shreejita56/MicroPAD-PROPLUS/README.md

# MicroPAD-PROPLUS


So I made a custom 3x3 Micropad based on Xiao RP2040 and it has  a rotor encoder on top . We have used diodes to prevent ghosting , the Switches are hot-swappable and it has a compact design.
<br>
The PCB Design was made on Kicad. Here I used the SMD Footprint for the Xiao Rp2040 and Hot-Swappable Footprint for the Switches . The rotor encoder at the top of the matrix also works as a switch . So In total We can use this MicroPad for 9 different Shortcuts and the rotor encoder can be used as a Volume Controller.Also It has per switch LEDS as well <br>

We have also used a Diode with each Switch , So that we can prevent Ghosting. The PCB also have few connection holes which helps it to connect with the CASE Properly.
<br>
I have tried to make the PCB design as compact as I could <br>

Then Comes the CAD . Which was Done in fusion . I Tracked the boundary of the PCB with come relief space then marked the Connection hole on the PCB as well . After which I designed the Bottom Case onto which the PCB Rests and Then I made a 3X3 Center case to hold the Switches and a Top case to add the finish and at the end I made hole for the USB-C connection and made the Base case in a angle so that It sits on a angle on the table.
<br>

Lastly I made the Firmware for the PCB which I wrote completely in C language .

### Features
- 3x3 Switch Design with rotor encoder on top
- Per switch LED and Diode for ghosting
- Compact Design
- Three layered Case with base (Structured at an angle )

  ## Usage Instructions

  So 'first I Soldered the Hot-Swapes onto the board and after that I soldered the diodes onto the other side ,prior to that I Soldered the LEDS and then at the END I soldered the Rotor Encoder and the Xiao Rp2040. After that I assembled the PCB onto the base and then I added the Switch assembles with the Middle layer onto the PCB and at the End I added the top layer CAD and added the KeyCaps. 

- # Bill of Materials (BOM)

| Item | Price (USD) | Source |
|---|---:|---|
| PCB + Shipping (after coupons) | 0 Already have| JLCPCB |
| Xiao RP2040 + Shipping | 0 Already have | https://robocraze.com/products/seeed-studio-xiao-rp2040-development-board |
| Keycaps (Pack of 5) ×2 | 0 Already have | https://meckeys.com/shop/accessories/keyboard-accessories/keycaps/blank/blank-dsa-keycaps-1u/ |
| Switches (Pack of 10) | 0 Already have| https://neomacro.in/products/hmx-snowfall-tactile-switch |
| Hot-Swap Sockets (Pack of 10) | 0 Already have| https://meckeys.com/shop/accessories/keyboard-accessories/key-switches/kailh-hot-swap-socket/ |
| Meckeys Shipping | 0 Already have | https://meckeys.com |
| Diodes (10 pcs) | Already have | — |
| Rotary Encoder | Already have | — |
| **Total** | **0.00** | |

## Schematics 


## PCB 




## 3D Design 



## Built View 



## Demo Link
youtube.com/shorts/5VS75XL_3SE?feature=share
