shreejita56/MicroPAD-PROPLUS/BOM.csv

Item | Price | Source
PCB + Shipping - Coupons | 0 Already have) | JLCPCB
Xiao Rp2040 + Shipping | 0 Already have | https://robocraze.com/products/seeed-studio-xiao-rp2040-development-board?variant=47742255562976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
Key Caps(pack of 5)x2 | 0 Already have | https://meckeys.com/shop/accessories/keyboard-accessories/keycaps/blank/blank-dsa-keycaps-1u/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
Switches(pack of 10) | 0 Already have | https://neomacro.in/products/hmx-snowfall-tactile-switch?variant=50878813503766
HotSwap(pack of 10) | 0 Already have | https://meckeys.com/shop/accessories/keyboard-accessories/key-switches/kailh-hot-swap-socket/
meckeys shipping | 0 Already have | meckeys.com
Diodes ( 10 pieces) | already have
rotor encoder | already have
Total | 0
