shreejita56/MicroPAD-PROPLUS/CAD/MacroPad ProPlus.step

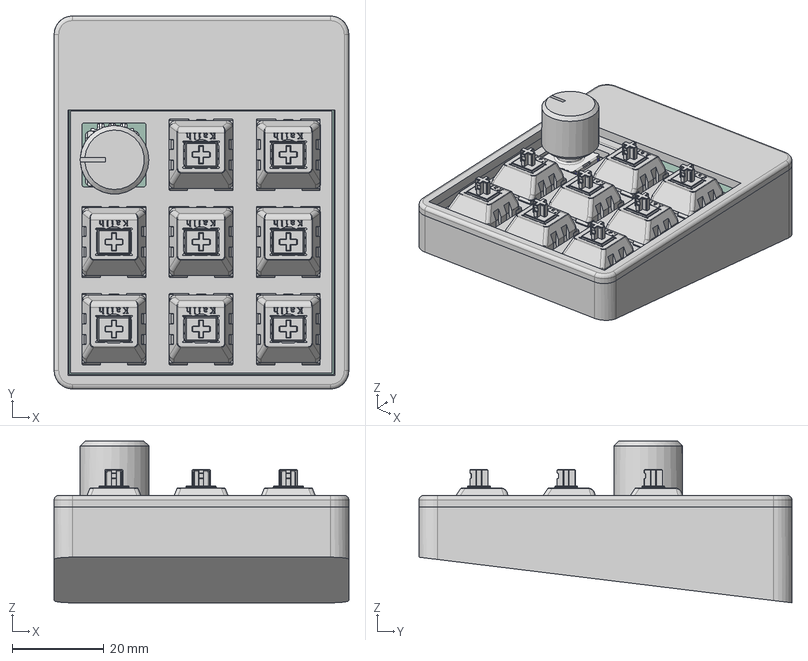
[picture p1: CAD file, 2026-10-09]
CAD/MacroPad ProPlus.step
64.4 x 81.5 x 35.3 mm
