shreejita56/MicroPAD-PROPLUS/Production/CAD/Base.stl

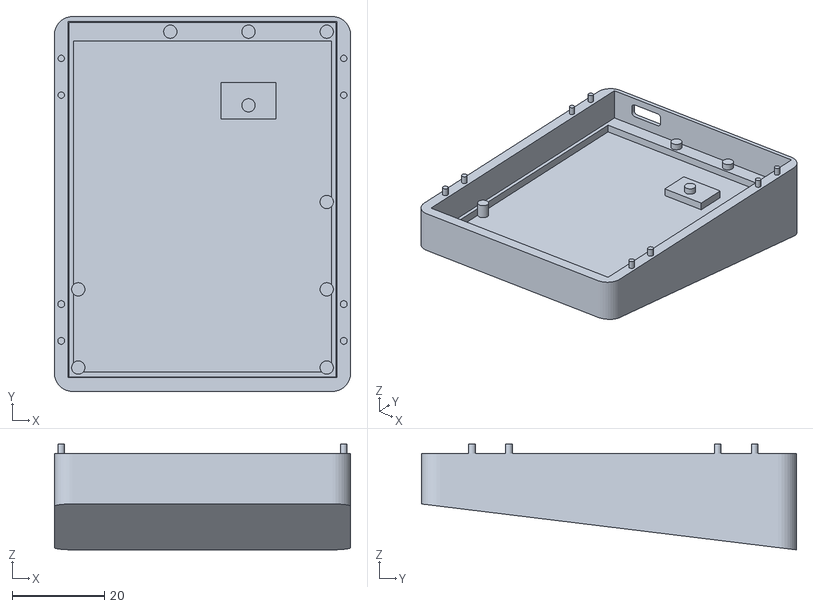
[picture p2: CAD file, 2026-10-09]
Production/CAD/Base.stl
64.4 x 81.5 x 23.0
