shreejita56/MicroPAD-PROPLUS/Production/CAD/Middle.stl

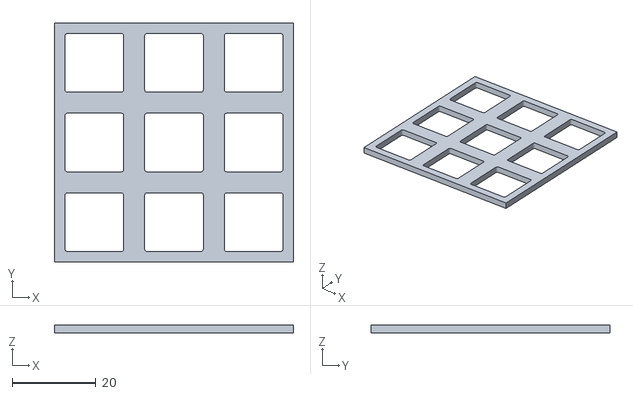
[picture p3: CAD file, 2026-10-09]
Production/CAD/Middle.stl
57.1 x 57.1 x 2.00
