shreejita56/MicroPAD-PROPLUS/Production/CAD/TOP.stl

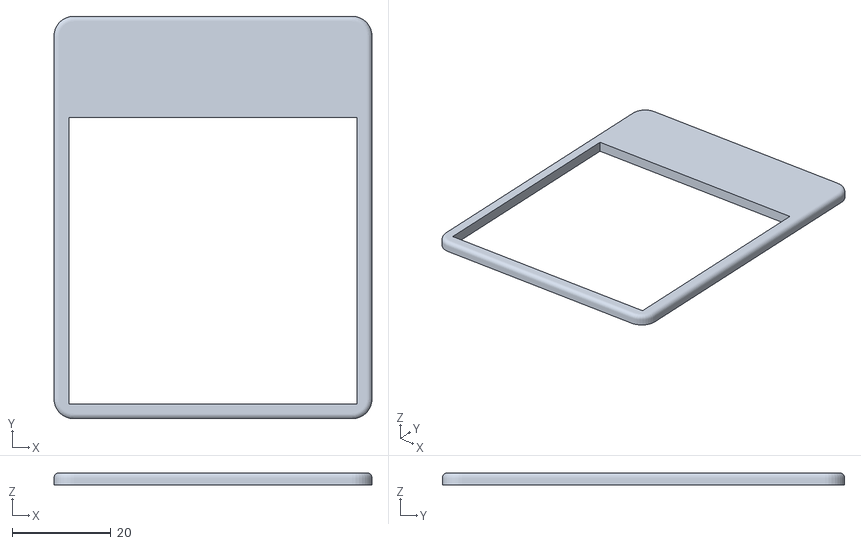
[picture p4: CAD file, 2026-10-09]
Production/CAD/TOP.stl
64.4 x 81.5 x 2.50
