shreejita56/MicroPAD-PROPLUS/(list of files, cad)

Other CAD files:
CAD/MacroPad ProPlus.f3d
