shreejita56/MicroPAD-PROPLUS/PCB/MicroPad ProPlus.kicad_pcb

## KiCad design PCB/MicroPad ProPlus.kicad_pcb (2026-10-09)

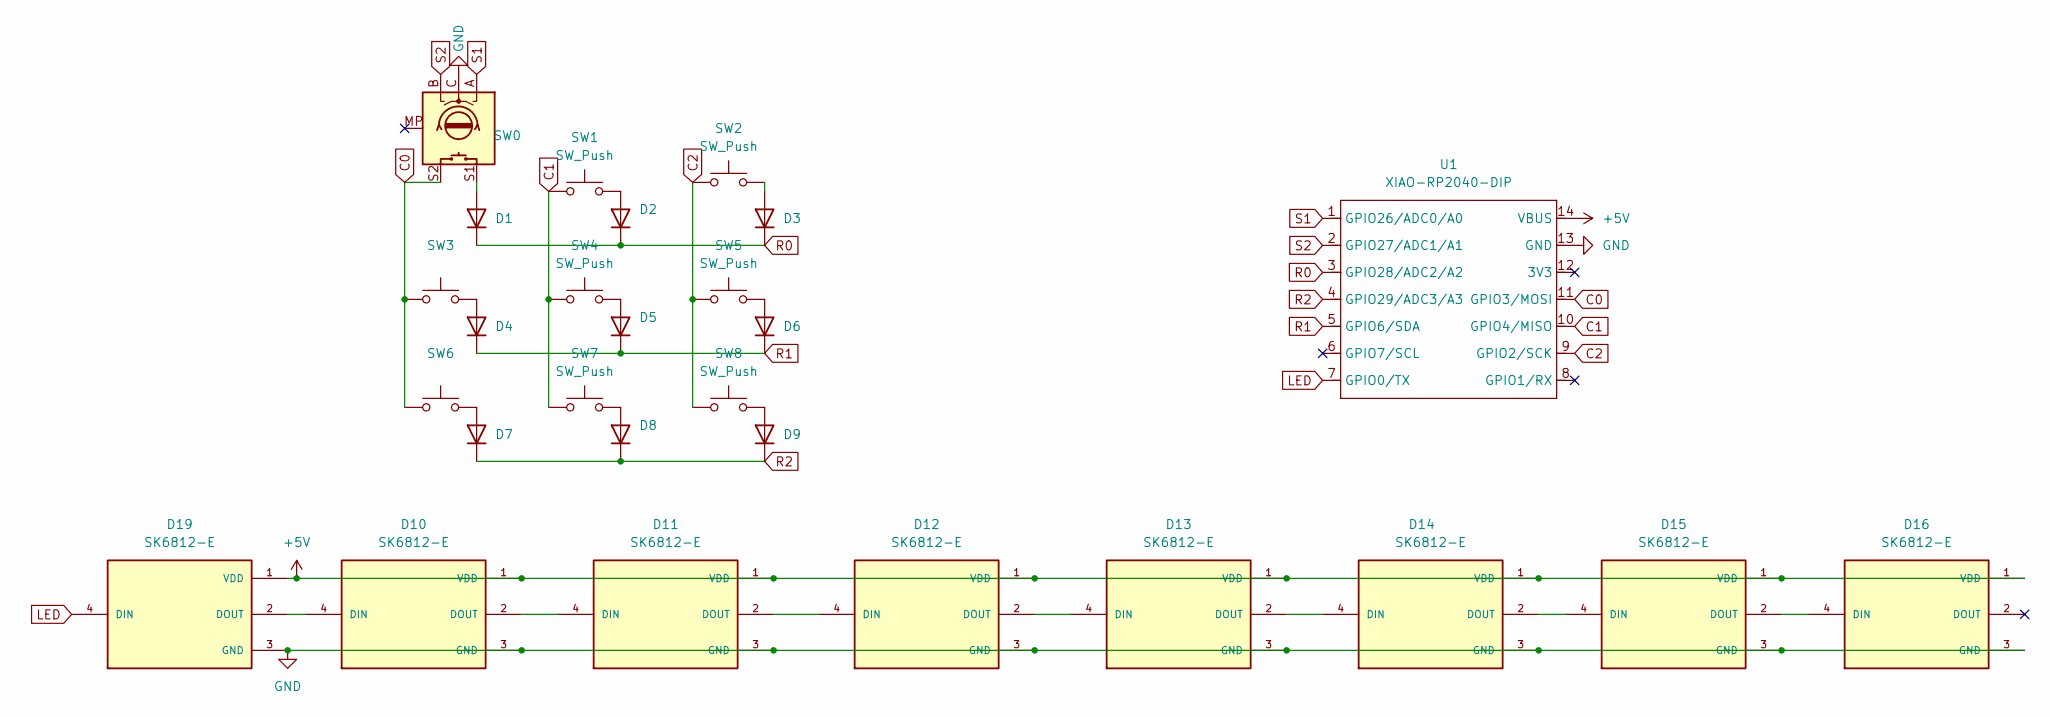
[picture p5: schematic MicroPad ProPlus.kicad_sch]

Parts:
D1, D2, D3, D4, D5, D6, D7, D8, D9: 1N4148; D_DO-35_SOD27_P7.62mm_Horizontal
D10, D11, D12, D13, D14, D15, D16, D19: SK6812-E; LED_SK6812-E; PARTREV 2
SW0: RotaryEncoder_Switch_MP; RotaryEncoder_Alps_EC11E-Switch_Vertical_H20mm
SW1, SW2, SW3, SW4, SW5, SW6, SW7, SW8: SW_Push; MX100H
U1: XIAO-RP2040-DIP

Connections:
+5V: D10.1 (VDD), D11.1 (VDD), D12.1 (VDD), D13.1 (VDD), D14.1 (VDD), D15.1 (VDD), D16.1 (VDD), D19.1 (VDD), U1.14 (VBUS); also elsewhere on the board
C0: SW0.S2, SW3.1, SW6.1, U1.11 (GPIO3/MOSI)
C1: SW1.1, SW4.1, SW7.1, U1.10 (GPIO4/MISO)
C2: SW2.1, SW5.1, SW8.1, U1.9 (GPIO2/SCK)
GND: D10.3 (GND), D11.3 (GND), D12.3 (GND), D13.3 (GND), D14.3 (GND), D15.3 (GND), D16.3 (GND), D19.3 (GND), SW0.C, U1.13 (GND); also elsewhere on the board
LED: D10.4 (DIN), D19.2 (DOUT), D19.4 (DIN), U1.7 (GPIO0/TX)
unnamed: D1.2 (A), SW0.S1
unnamed: D2.2 (A), SW1.2
unnamed: D3.2 (A), SW2.2
unnamed: D4.2 (A), SW3.2
unnamed: D5.2 (A), SW4.2
unnamed: D6.2 (A), SW5.2
unnamed: D7.2 (A), SW6.2
unnamed: D8.2 (A), SW7.2
unnamed: D9.2 (A), SW8.2
unnamed: D10.2 (DOUT), D11.4 (DIN)
unnamed: D11.2 (DOUT), D12.4 (DIN)
unnamed: D12.2 (DOUT), D13.4 (DIN)
unnamed: D13.2 (DOUT), D14.4 (DIN)
unnamed: D14.2 (DOUT), D15.4 (DIN)
unnamed: D15.2 (DOUT), D16.4 (DIN)
unnamed 21: D16.2 (DOUT); also elsewhere on the board
R0: D1.1 (K), D2.1 (K), D3.1 (K), U1.3 (GPIO28/ADC2/A2)
R1: D4.1 (K), D5.1 (K), D6.1 (K), U1.5 (GPIO6/SDA)
R2: D7.1 (K), D8.1 (K), D9.1 (K), U1.4 (GPIO29/ADC3/A3)
S1: SW0.A, U1.1 (GPIO26/ADC0/A0)
S2: SW0.B, U1.2 (GPIO27/ADC1/A1)

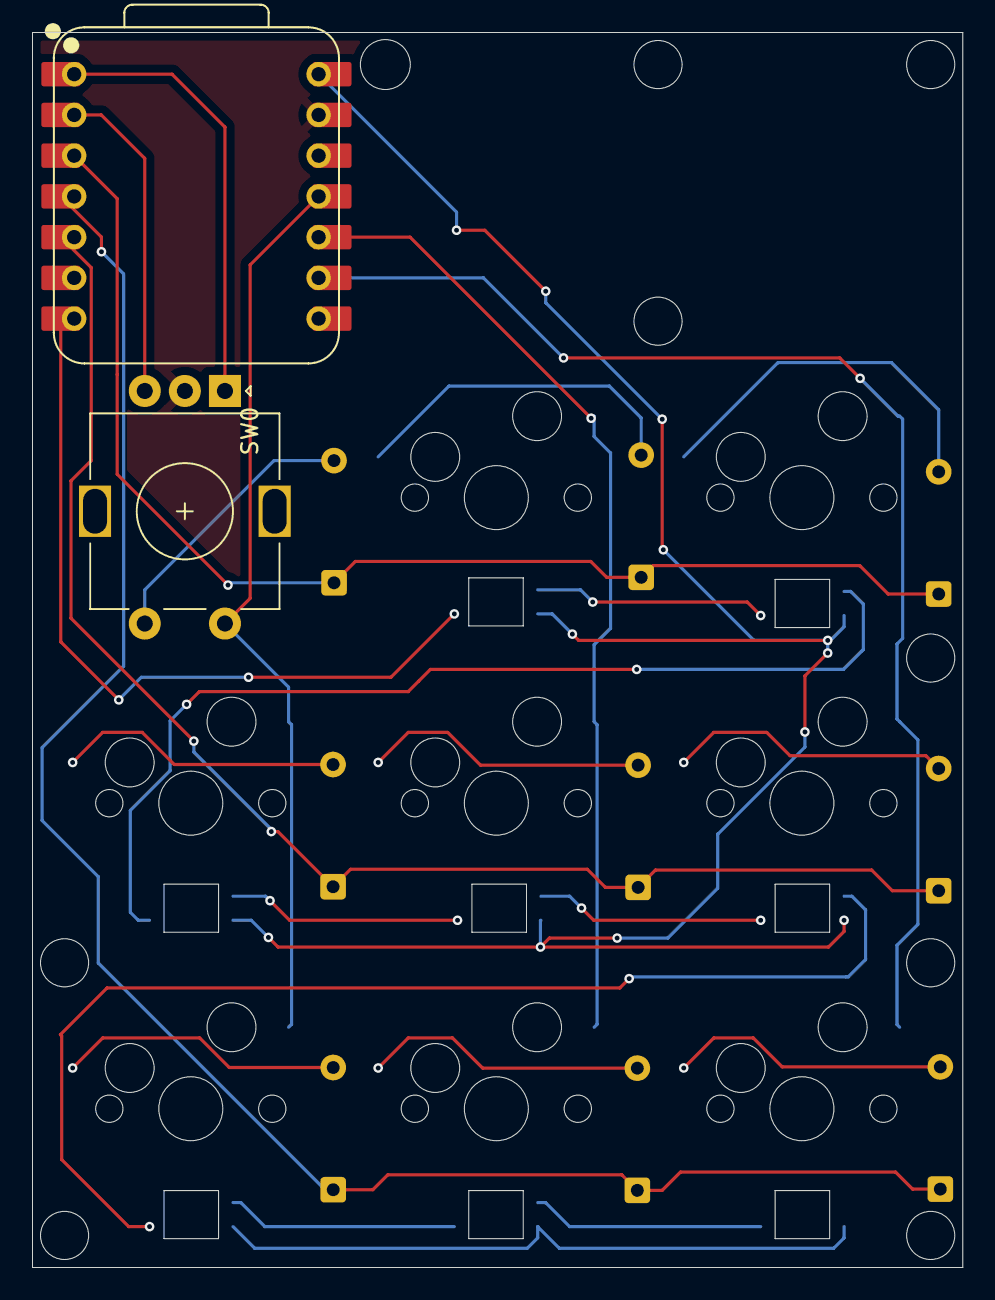
[picture p6: board MicroPad ProPlus.kicad_pcb from above]

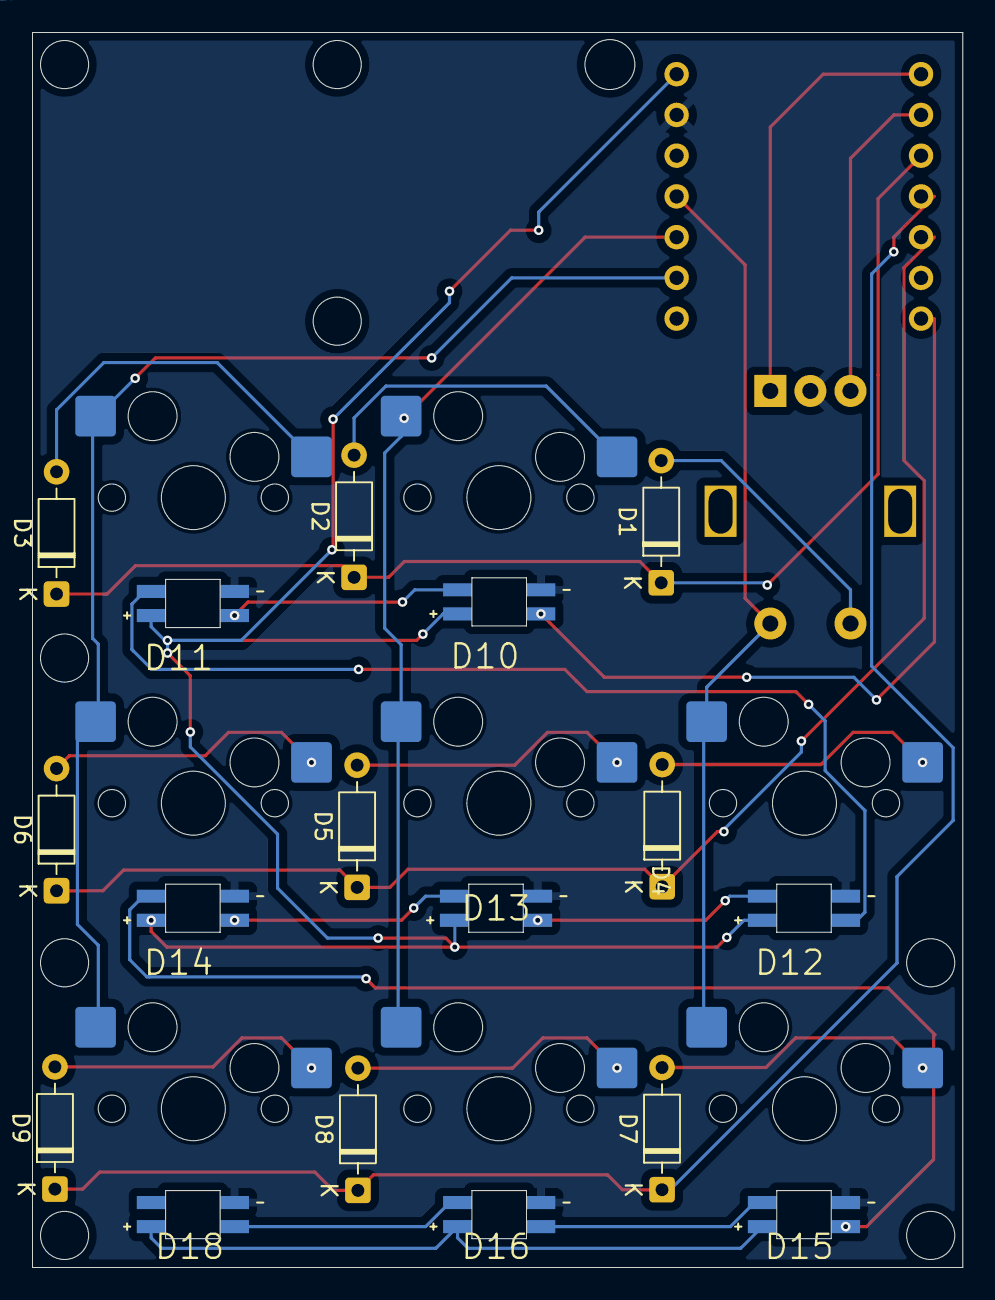
[picture p7: board MicroPad ProPlus.kicad_pcb from below]

Board: 2 copper layers, 58.0 x 77.0 mm, 27 parts (25 on the bottom side), 27 nets.

Other parts of the board:
D18: SK6812-E; LED_SK6812-E

Their connections:
+5V: D18.1 (VDD); also elsewhere on the board
GND: D18.3 (GND); also elsewhere on the board
unnamed 21: D18.4 (DIN); also elsewhere on the board
